kimmoli/kimdle/osaluettelo.xls

Qty | Value | Device | Package | Parts | Unit Price | Digikey part | Description | Ext Price
2 |  | SJ | SJ-SMALL | SJ1, SJ2 |  |  |  | 0
8 | 100n | C-EUC0603 | C0603 | C8, C9, C10, C11, C12, C13, C19, C22 | 0.00516 | 1276-1011-1-ND | CAP CER 0.1UF 25V Y5V 0603 | 0.04128
19 | 10k | R-EU_R0603 | R0603 | R1, R2, R4, R5, R6, R8, R9, R10, R15, R19, R20, R21, R22, R23, R24, R26, R31, R32, R33 | 0.0087 | RMCF0603FT10K0CT-ND | RES 10K OHM 1/10W 1% 0603 | 0.1653
5 | 10u 10V | C-EUC0805 | C0805 | C15, C18, C20, C21, C25 | 0.068 | 311-1355-1-ND | CAP CER 10UF 10V Y5V 0805 | 0.34
2 | 12p | C-EUC0603 | C0603 | C23, C24 | 0.016 | 1276-1254-1-ND | CAP CER 12PF 50V 5% NP0 0603 | 0.032
1 | 160k | R-EU_R0603 | R0603 | R7 | 0.067 | 541-160KHCT-ND | RES 160K OHM 1/10W 1% 0603 SMD | 0.067
1 | 165k | R-EU_R0603 | R0603 | R3 | 0.067 | 541-165KHCT-ND | RES 165K OHM 1/10W 1% 0603 SMD | 0.067
3 | 1u 50V | C-EUC0805 | C0805 | C1, C7, C14 | 0.0416 | 1276-1029-1-ND | CAP CER 1UF 50V 10% X7R 0805 | 0.1248
3 | 22R | R-EU_R0603 | R0603 | R16, R17, R34 | 0.0114 | RMCF0603FT22R0CT-ND | RES 22 OHM 1/10W 1% 0603 | 0.0342
2 | 2k15 | R-EU_R0603 | R0603 | R27, R28 | 0.0087 | RMCF0603FT2K20CT-ND | RES 2.2K OHM 1/10W 1% 0603 | 0.0174
2 | 47n | C-EUC0805 | C0805 | C16, C17 | 0.0258 | 399-1166-1-ND | CAP CER 0.047UF 50V 10% X7R 0805 | 0.0516
5 | 4u7 50V | C-EUC0805 | C0805 | C2, C3, C4, C5, C6 | 0.0816 | 1276-1248-1-ND | CAP CER 4.7UF 50V 10% X5R 0805 | 0.408
5 | 511R | R-EU_R0603 | R0603 | R11, R12, R13, R14, R25 | 0.0114 | RMCF0603FT511RCT-ND | RES 511 OHM 1/10W 1% 0603 | 0.057
1 | 629105136821 | 629105136821 | 629105136821 | X4 | 1.95 | 732-3155-1-ND | CONN RCPT USB MICRO B R/A SMT | 1.95
1 | 693071010811 | 693071010811 | 693071010811 | X5 | 1.96 | 732-3819-1-ND | CONN MICRO SD 8 POS SMD | 1.96
1 | ADP5063 | ADP5063 | QFN50P400X400X80-21N | N6 | 0 | Free sample | Linear LiFePO4 Battery Charger | 0
1 | AST7525MATRQ | AST7525MATRQ | AST7525MATRQ | E4 | 1.61 | 458-1100-1-ND | BUZZER MAG 2.7KHZ 2.5-4.5VAC SMT | 1.61
3 | FDV304 | DMG2307LSOT23 | SOT23 | V3, V4, V5 | 0.283 | FDV304PCT-ND | MOSFET P-CH 25V 460MA SOT-23 | 0.849
1 | ED060SC4_EINK | ED060SC4_EINK | FH26-39S-0.3SHW | X1 | 2.63 | HFQ339CT-ND | CONN FPC/FFC 39POS .3MM HORZ SMD | 2.63
3 | GRN | LEDCHIP-LED0603 | CHIP-LED0603 | H1, H2, H3 | 0.0563 | 475-1409-1-ND | LED CHIPLED 570NM GREEN 0603 SMD | 0.1689
2 | LPS4018B | LPS4018B | LPS4018_V2 | L1, L2 | 0.284 | 587-2886-1-ND | INDUCTOR POWER 10UH 1.2A SMD | 0.568
1 | LT3463EDD | LT3463EDD | DFN300X300X80-11N | N1 | 3.42 | LT3463AEDD#PBF-ND | IC REG INV ADJ 0.25A DL 10DFN | 3.42
1 | LM358 | MAX412CPAMSOP | SOP65P490X110-8N | N5 | 0.318 | 296-18457-1-ND | IC OPAMP GP 700KHZ DUAL 8VSSOP | 0.318
1 | MC78L15ACDG | MC78L15ACDG | SOIC127P600X175-8N | N2 | 0.33 | 497-7278-1-ND | IC REG LDO 15V 0.1A 8SO | 0.33
1 | MC79L15ACDG | MC79L15ACDG | SOIC127P600X175-8N | N3 | 0.37 | MC79L15ABDGOS-ND | IC REG LDO -15V 0.1A 8SOIC | 0.37
1 | MCP1700T-3302E/TT | MCP1700T-3302E/TT | SOT95P237X112-3N | N4 | 0.305 | MCP1700T3302ETTCT-ND | IC REG LDO 3.3V 0.25A SOT23-3 | 0.305
4 | PIIKKIRIMA-2 | PIIKKIRIMA-2 | PIIKKIRIMA-2 | X3, X7, X8, X9 |  | oma varasto |  | 0
1 | PIIKKIRIMA-4 | PIIKKIRIMA-4 | PIIKKIRIMA-4 | X10 |  | oma varasto |  | 0
1 | PIIKKIRIMA-5 | PIIKKIRIMA-5 | PIIKKIRIMA-5 | X2 |  | oma varasto |  | 0
1 | PIIKKIRIMA-6 | PIIKKIRIMA-6 | PIIKKIRIMA-6 | X6 |  | oma varasto |  | 0
1 | PMEG6010 | DIODE-SOD323-R | SOD323-R | V1 | 0.276 | 568-4138-1-ND | DIODE SCHOTTKY 60V 1A SOD323F | 0.276
1 | STM32L151R8T6 | STM32L151R8T6 | QFP50P1200X1200X160-64N | D1 | 4.73 | 497-11192-ND | MCU ARM 64KB FLASH 64LQFP | 4.73
1 | TMP75DGK | TMP75DGK | MSOP8 | D2 | 0.51 | 568-4768-1-ND | IC TEMP SENSOR DGTL 8-TSSOP | 0.51
1 | XTAL_3225_SMD | XTAL_3225_SMD | X_3225 | G1 | 0.68 | 887-1462-1-ND | CRYSTAL 16MHZ 12PF SMD | 0.68
2 | YEL | LEDCHIP-LED0603 | CHIP-LED0603 | H4, H5 | 0.563 | 475-2557-1-ND | LED CHIPLED 587NM YLW 0603 SMD | 1.126
 |  |  |  |  |  |  | Total | 23.20648
