kimmoli/kimdle/schema.pdf

## EINK DISPLAY POWER SUPPLY

# KIMDLE V1.0

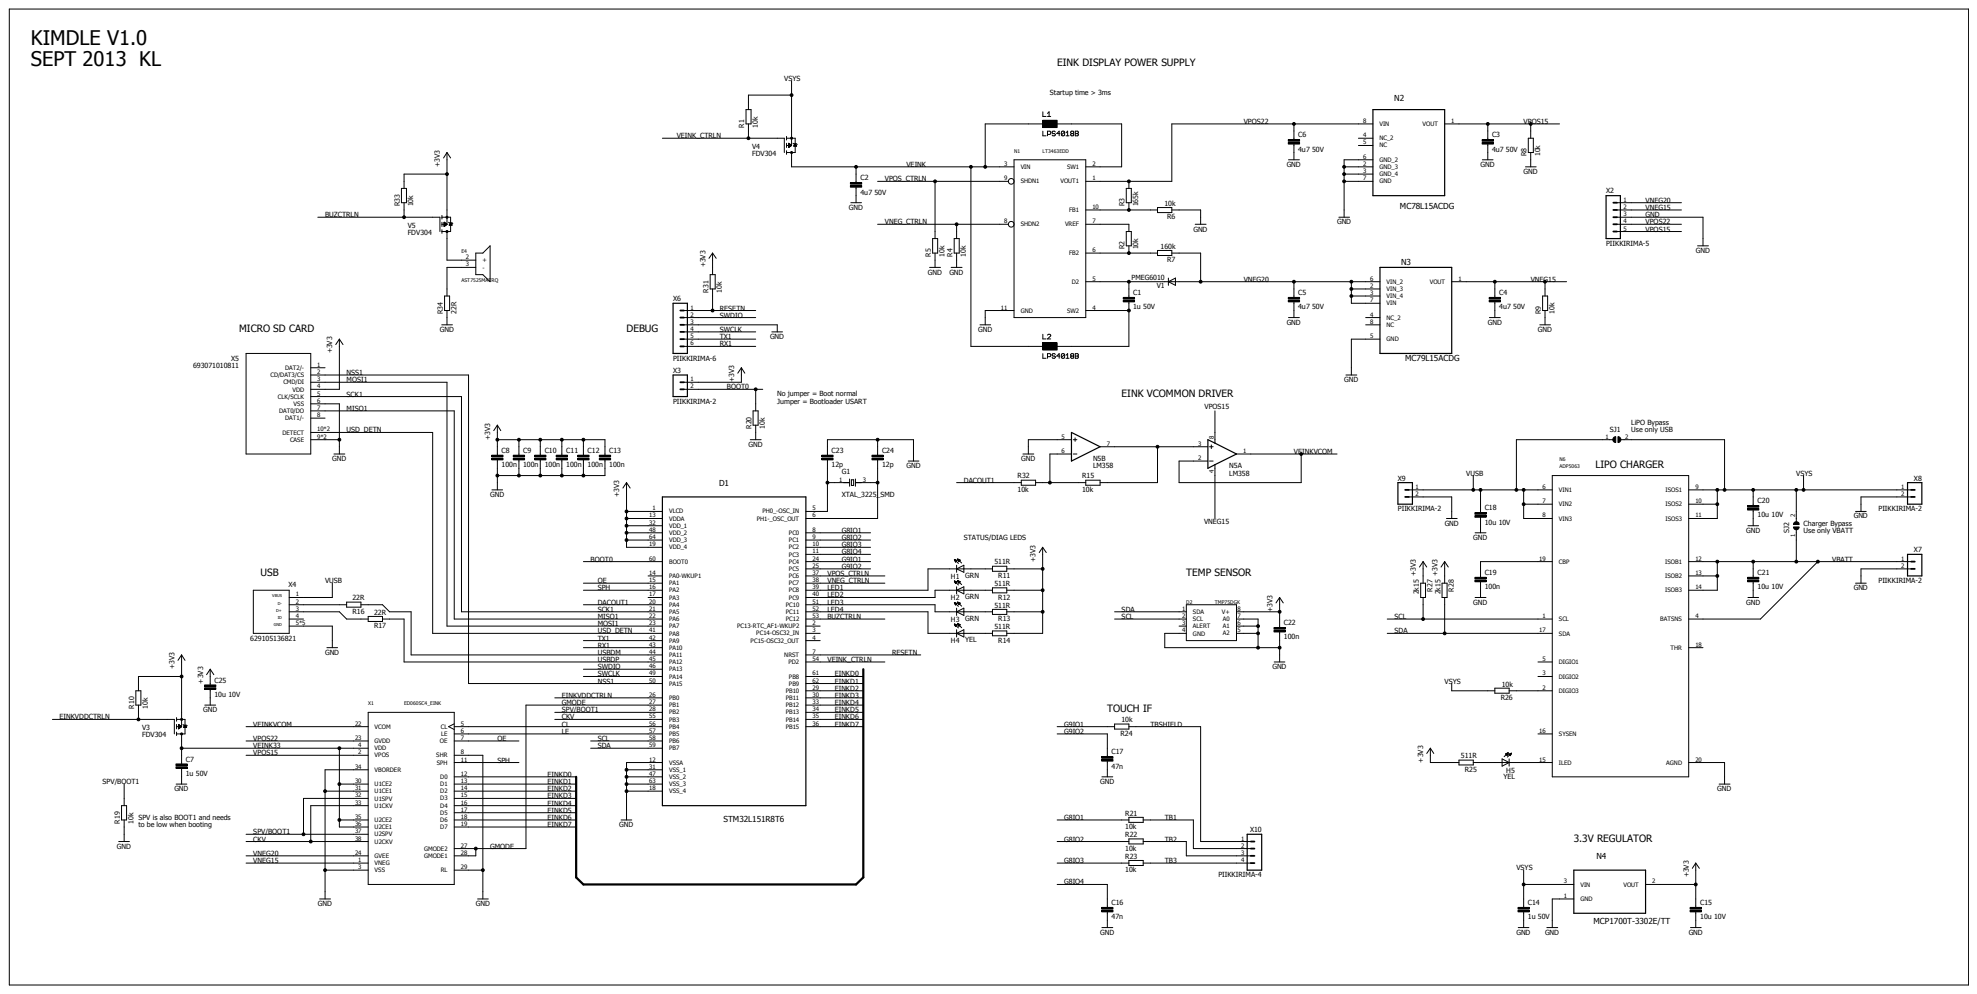
[picture p1: page 1]

No jumper = Boot normal
Jumper = Bootloader USART

SPV is also BOOT1 and needs
to be low when booting
