kimmoli/kimdle/gerber.pdf

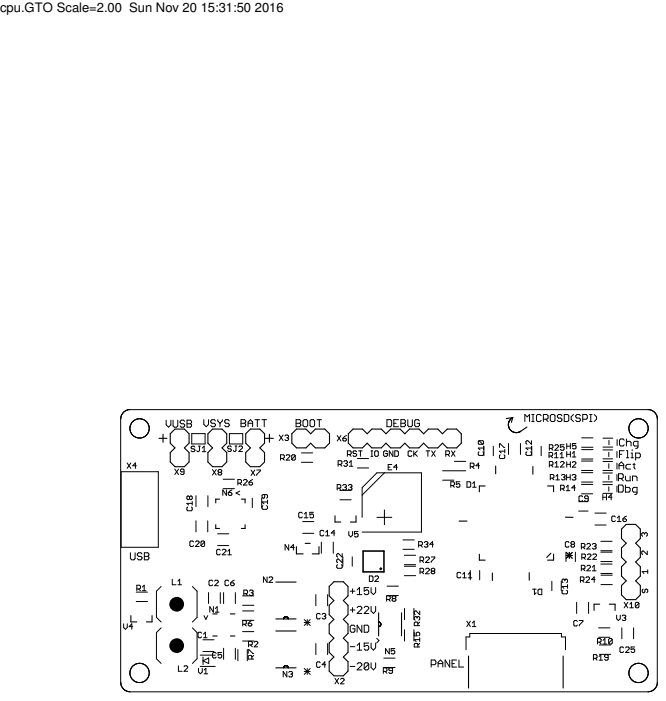
[picture p2: page 1]

cpu.GTO Scale=2.00 Sun Nov 20 15:31:50 2016

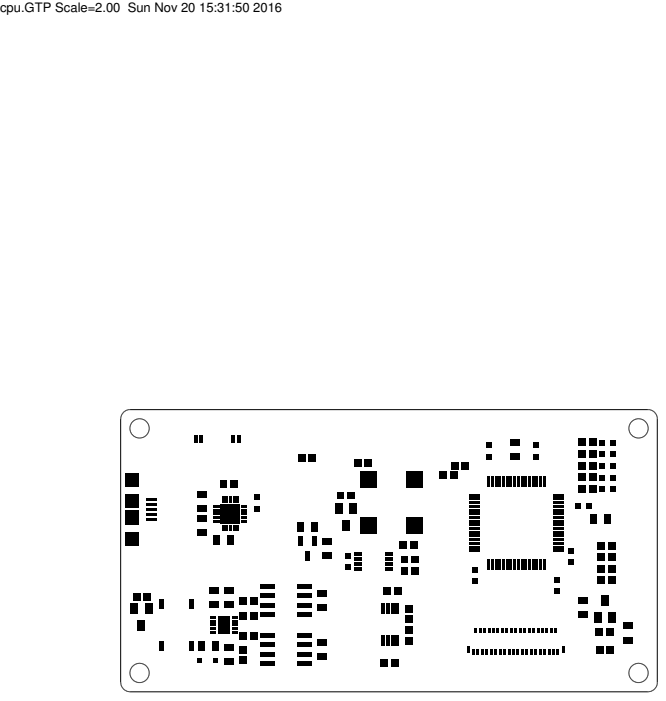
[picture p3: page 2]

cpu.GTP Scale=2.00 Sun Nov 20 15:31:50 2016

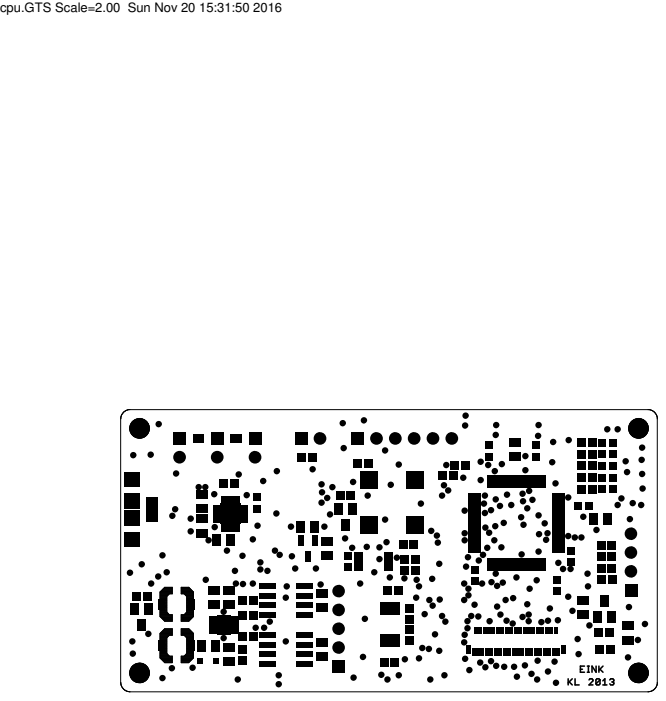
[picture p4: page 3]

cpu.GTS Scale=2.00 Sun Nov 20 15:31:50 2016

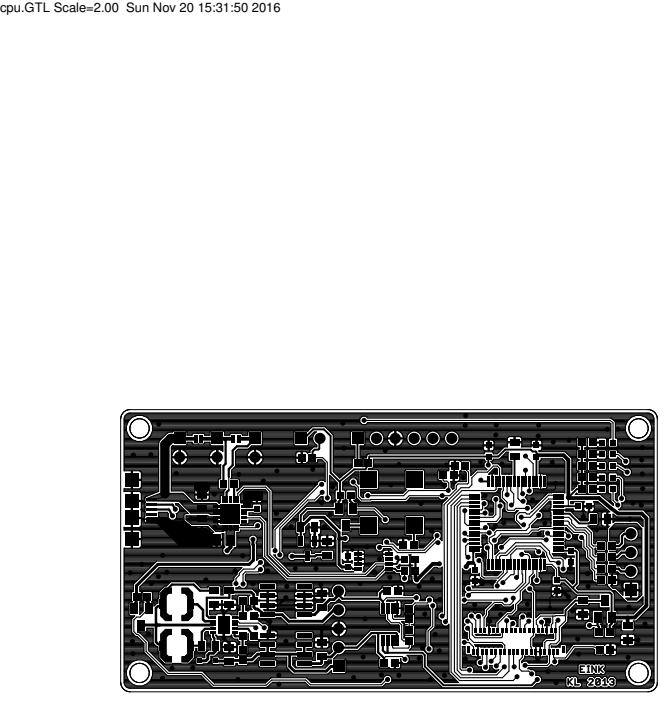
[picture p5: page 4]

cpu.GTL Scale=2.00 Sun Nov 20 15:31:50 2016

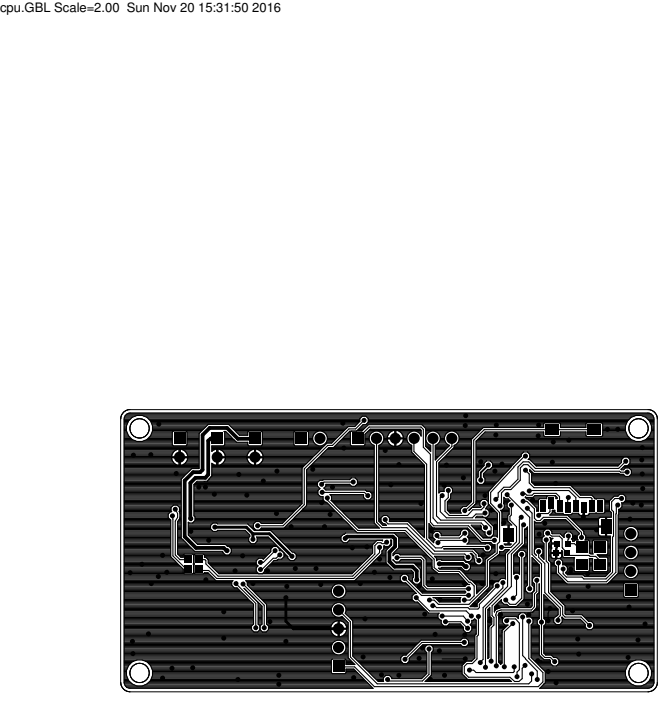
[picture p6: page 5]

cpu.GBL Scale=2.00 Sun Nov 20 15:31:50 2016

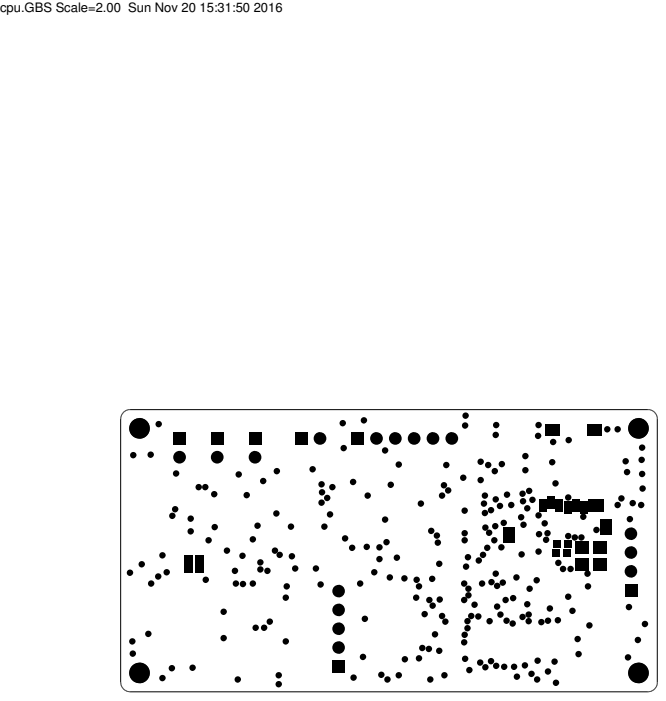
[picture p7: page 6]

cpu.GBS Scale=2.00 Sun Nov 20 15:31:50 2016

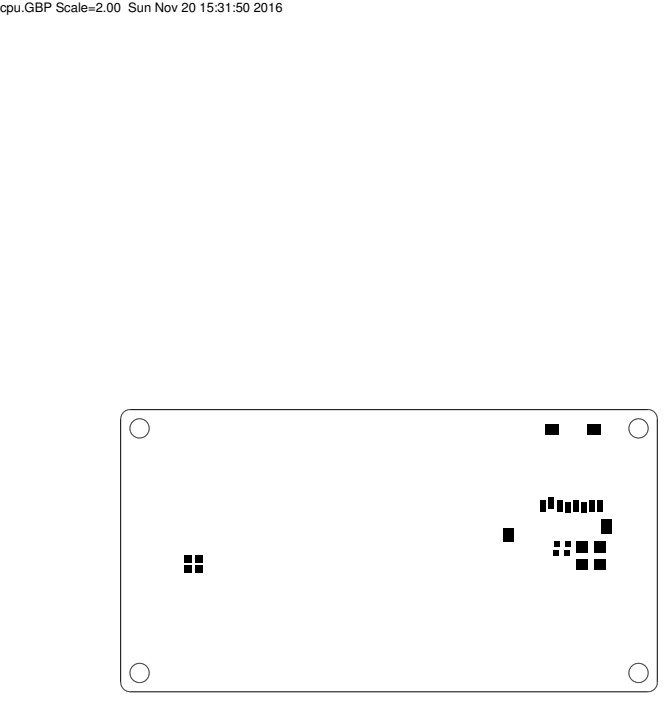
[picture p8: page 7]

cpu.GBP Scale=2.00 Sun Nov 20 15:31:50 2016

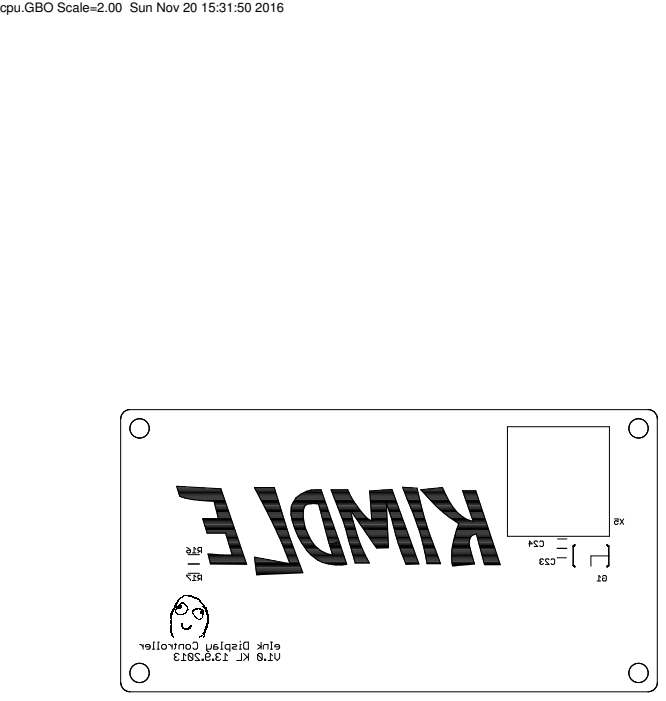
[picture p9: page 8]

cpu.GBO Scale=2.00 Sun Nov 20 15:31:50 2016

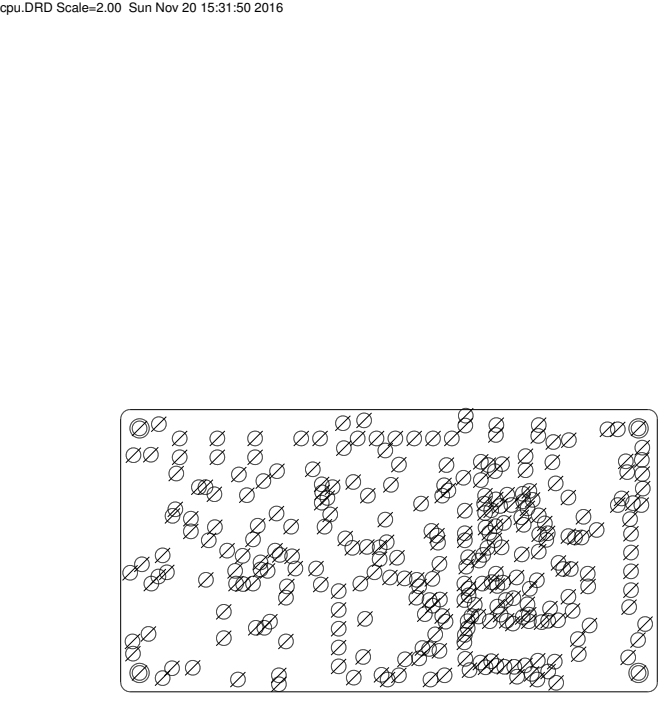
[picture p10: page 9]

cpu.DRD Scale=2.00 Sun Nov 20 15:31:50 2016

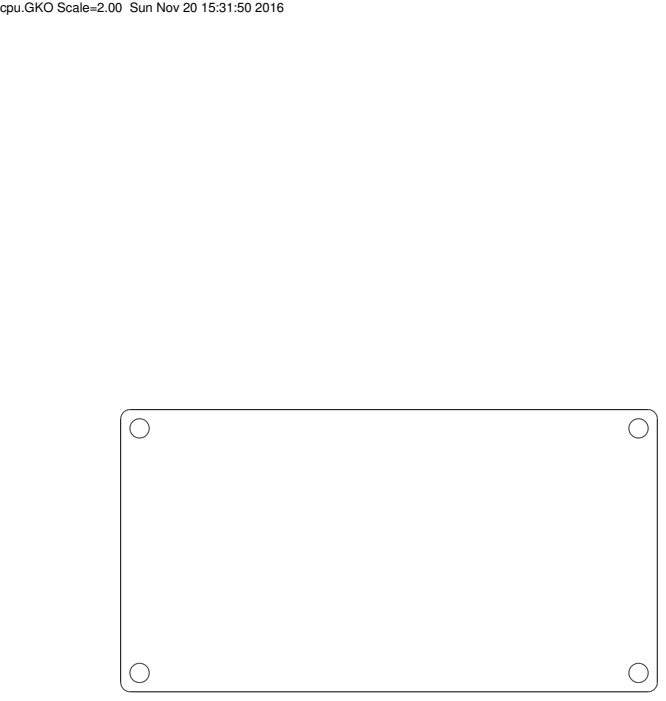
[picture p11: page 10]

cpu.GKO Scale=2.00 Sun Nov 20 15:31:50 2016

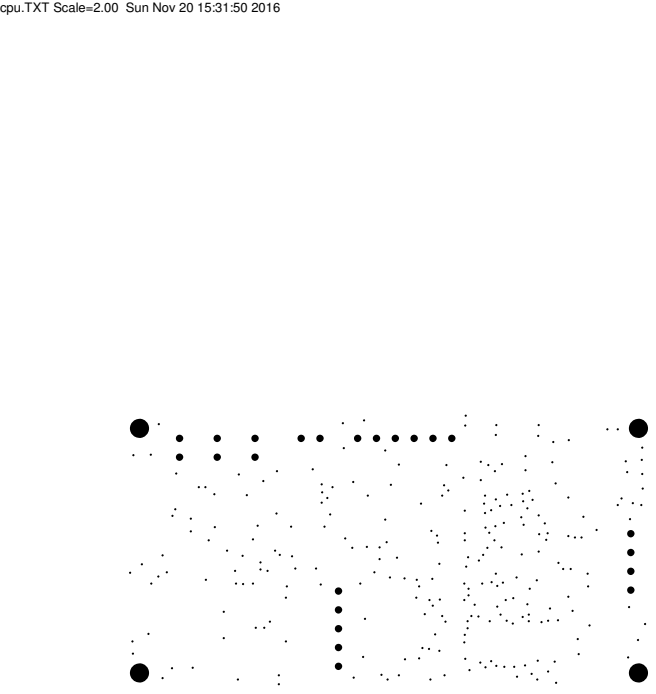
[picture p12: page 11]

cpu.TXT Scale=2.00 Sun Nov 20 15:31:50 2016
