kimmoli/kimdle/cpu.brd

## EAGLE design cpu.brd (2013-09-13)

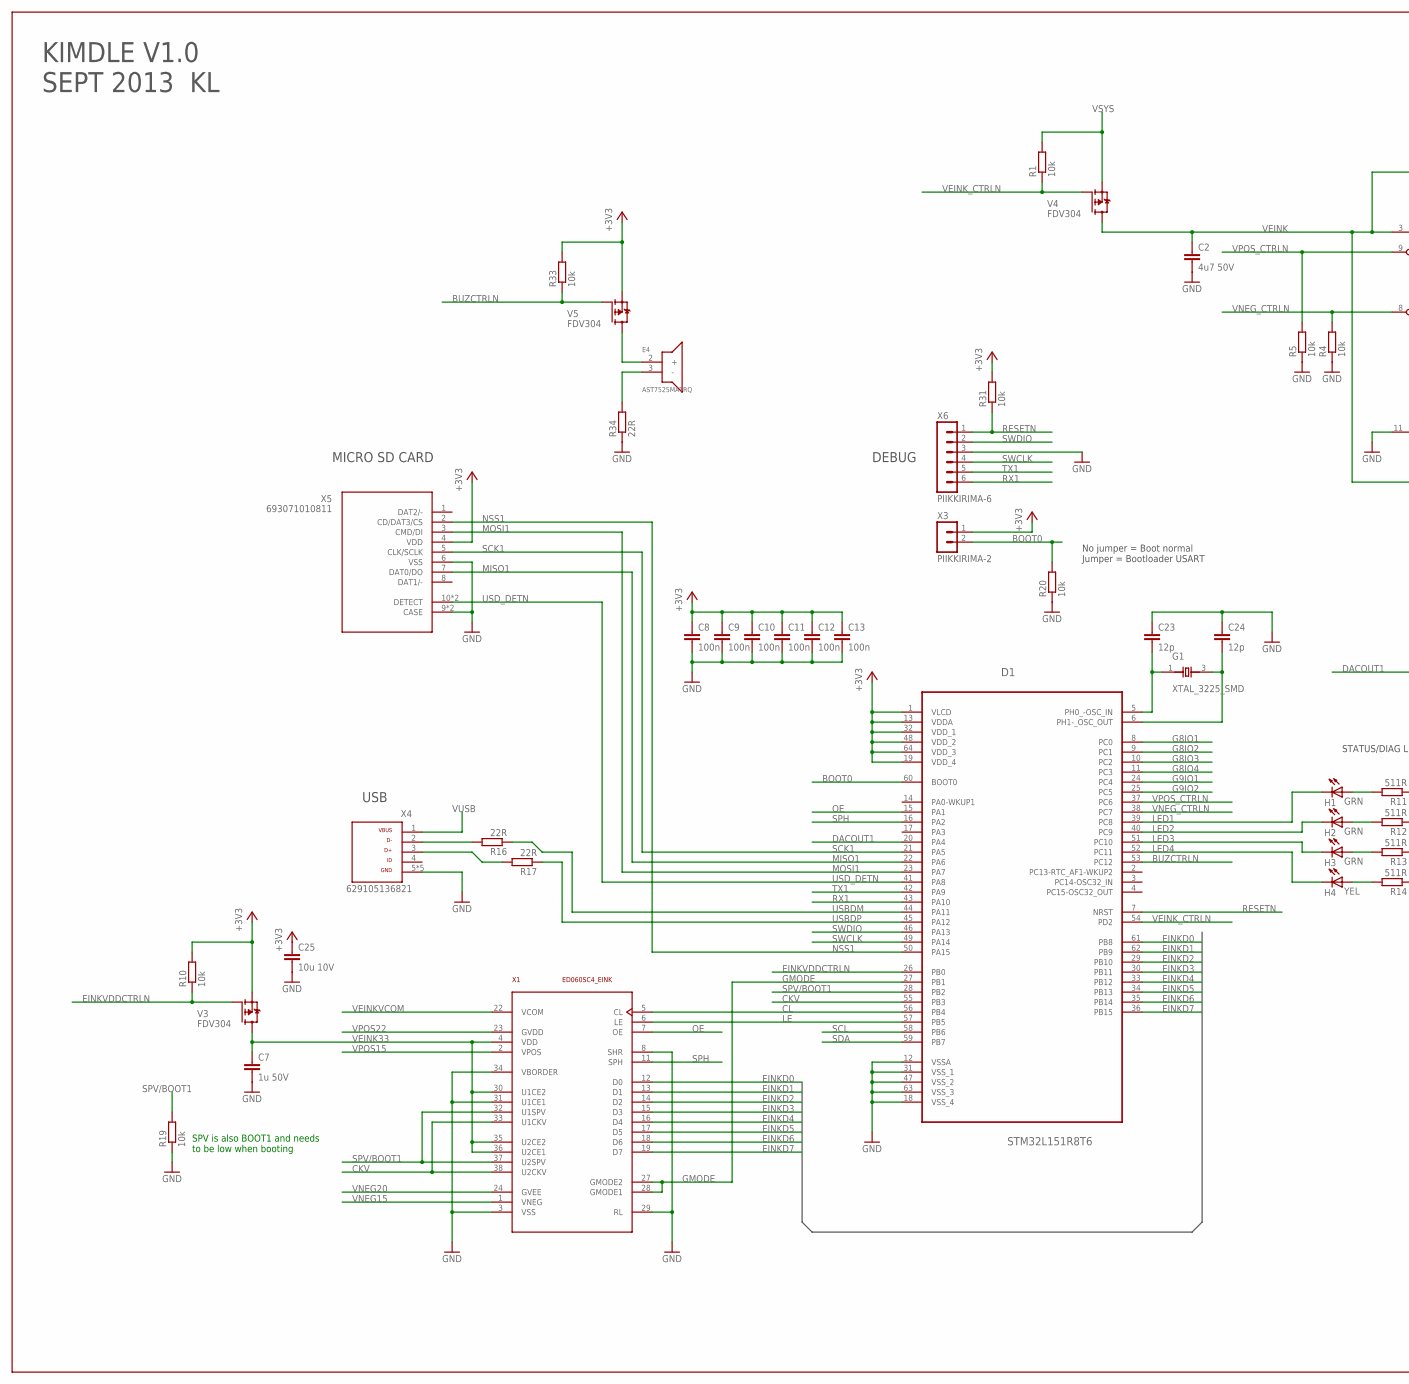
[picture p13: schematic cpu.sch, part in row 1, column 1]

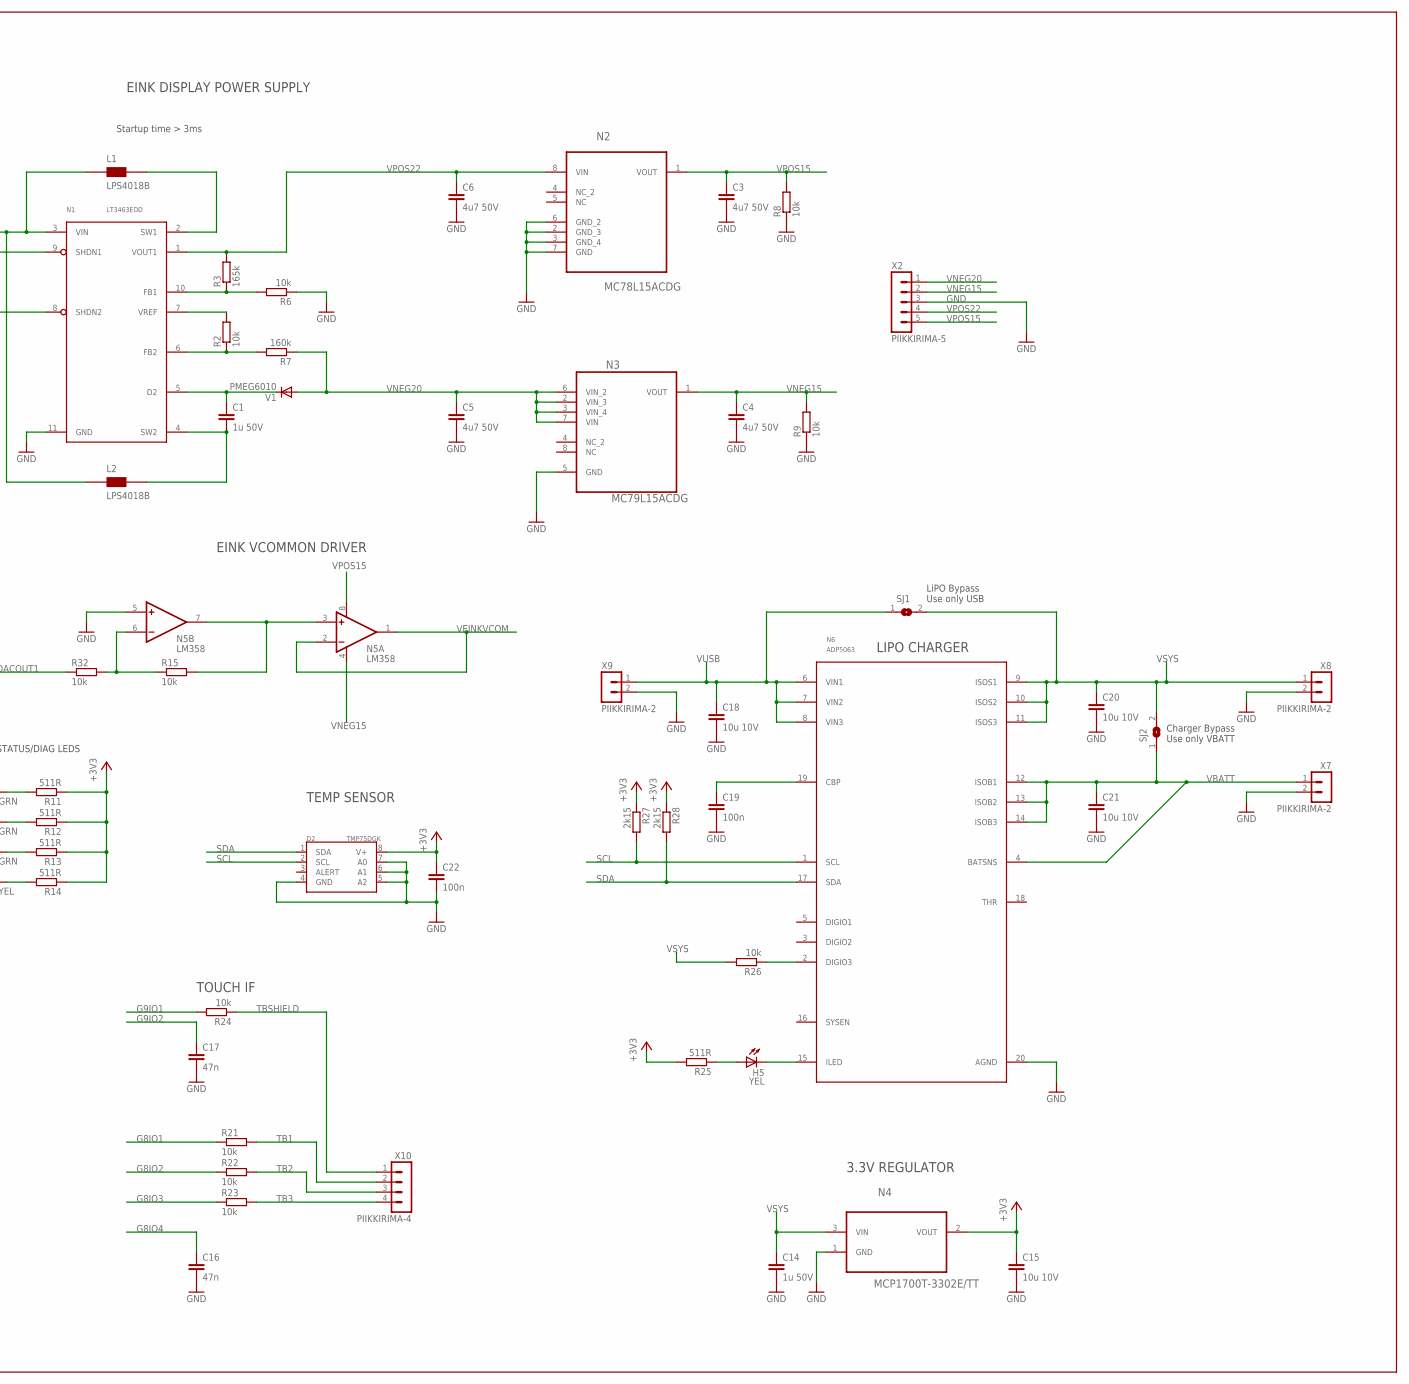
[picture p14: schematic cpu.sch, part in row 1, column 2]

Parts:
C1, C7, C14: 1u 50V; C0805
C2, C3, C4, C5, C6: 4u7 50V; C0805
C8, C9, C10, C11, C12, C13, C19, C22: 100n; C0603
C15, C18, C20, C21, C25: 10u 10V; C0805
C16, C17: 47n; C0805
C23, C24: 12p; C0603
D1: STM32L151R8T6; QFP50P1200X1200X160-64N
D2: TMP75DGK; MSOP8
E4: AST7525MATRQ
G1: XTAL_3225_SMD; X_3225
H1, H2, H3: GRN; CHIP-LED0603
H4, H5: YEL; CHIP-LED0603
L1, L2: LPS4018B; LPS4018_V2
N1: LT3463EDD; DFN300X300X80-11N
N2: MC78L15ACDG; SOIC127P600X175-8N
N3: MC79L15ACDG; SOIC127P600X175-8N
N4: MCP1700T-3302E/TT; SOT95P237X112-3N
N5: LM358; SOP65P490X110-8N
N6: ADP5063; QFN50P400X400X80-21N
R1, R2, R4, R5, R6, R8, R9, R10, R15, R19, R20, R21, R22, R23, R24, R26, R31, R32, R33: 10k; R0603
R3: 165k; R0603
R7: 160k; R0603
R11, R12, R13, R14, R25: 511R; R0603
R16, R17, R34: 22R; R0603
R27, R28: 2k15; R0603
SJ1, SJ2: SJ; SJ-SMALL
V1: PMEG6010; SOD323-R
V3, V4, V5: FDV304; SOT23
X1: ED060SC4_EINK; FH26-39S-0.3SHW
X2: PIIKKIRIMA-5
X3, X7, X8, X9: PIIKKIRIMA-2
X4: 629105136821
X5: 693071010811
X6: PIIKKIRIMA-6
X10: PIIKKIRIMA-4

Connections:
+3V3: C8.1, C9.1, C10.1, C11.1, C12.1, C13.1, C15.1, C22.1, C25.1, D1.1 (VLCD), D1.13 (VDDA), D1.19 (VDD_4), D1.32 (VDD_1), D1.48 (VDD_2), D1.64 (VDD_3), D2.8 (V+), N4.2 (VOUT), R10.2, R11.1, R12.1, R13.1, R14.1, R25.2, R27.1, R28.1, R31.2, R33.2, V3.2 (S), V5.2 (S), X3.1, X5.4 (VDD)
BOOT0: D1.60 (BOOT0), R20.2, X3.2
BUZCTRLN: D1.53 (PC12), R33.1, V5.1 (G)
CKV: D1.55 (PB3), X1.33 (U1CKV), X1.38 (U2CKV)
CL: D1.56 (PB4), X1.5 (CL)
DACOUT1: D1.20 (PA4), R32.1
EINKD0: D1.61 (PB8), X1.12 (D0)
EINKD1: D1.62 (PB9), X1.13 (D1)
EINKD2: D1.29 (PB10), X1.14 (D2)
EINKD3: D1.30 (PB11), X1.15 (D3)
EINKD4: D1.33 (PB12), X1.16 (D4)
EINKD5: D1.34 (PB13), X1.17 (D5)
EINKD6: D1.35 (PB14), X1.18 (D6)
EINKD7: D1.36 (PB15), X1.19 (D7)
EINKVDDCTRLN: D1.26 (PB0), R10.1, V3.1 (G)
G8IO1: D1.8 (PC0), R21.1
G8IO2: D1.9 (PC1), R22.1
G8IO3: D1.10 (PC2), R23.1
G8IO4: C16.1, D1.11 (PC3)
G9IO1: D1.24 (PC4), R24.2
G9IO2: C17.1, D1.25 (PC5)
GMODE: D1.27 (PB1), X1.27 (GMODE2), X1.28 (GMODE1)
GND: C2.2, C3.2, C4.2, C5.2, C6.2, C7.2, C8.2, C9.2, C10.2, C11.2, C12.2, C13.2, C14.2, C15.2, C16.2, C17.2, C18.2, C19.2, C20.2, C21.2, C22.2, C23.1, C24.1, C25.2, D1.12 (VSSA), D1.18 (VSS_4), D1.31 (VSS_1), D1.47 (VSS_2), D1.63 (VSS_3), D2.4 (GND), D2.5 (A2), D2.6 (A1), D2.7 (A0), N1.11 (GND), N2.2 (GND_3), N2.3 (GND_4), N2.6 (GND_2), N2.7 (GND), N3.5 (GND), N4.1 (GND), N5.5 (+IN), N6.20 (AGND), R4.1, R5.1, R6.1, R8.1, R9.1, R19.1, R20.1, R34.1, X1.3 (VSS), X1.8 (SHR), X1.29 (RL), X1.31 (U1CE1), X1.34 (VBORDER), X2.3, X4.5, X4.Z1 (5), X4.Z2 (5), X4.Z3 (5), X4.Z4 (5), X5.6 (VSS), X5.9 (CASE), X5.9B (CASE), X6.3, X7.2, X8.2, X9.2
LE: D1.57 (PB5), X1.6 (LE)
LED1: D1.39 (PC8), H1.C
LED2: D1.40 (PC9), H2.C
LED3: D1.51 (PC10), H3.C
LED4: D1.52 (PC11), H4.C
MISO1: D1.22 (PA6), X5.7 (DAT0/DO)
MOSI1: D1.23 (PA7), X5.3 (CMD/DI)
unnamed: C1.1, N1.5 (D2), V1.C
unnamed: R17.2, X4.3
unnamed: N1.6 (FB2), R2.1, R7.2
unnamed: R16.2, X4.2
unnamed: E4.3 (-), R34.2
unnamed: L1.2 (B), N1.2 (SW1)
unnamed: C1.2, L2.2 (B), N1.4 (SW2)
unnamed: N5.3 (+IN), N5.7 (OUT), R15.2
unnamed: N1.7 (VREF), R2.2
unnamed: H1.A, R11.2
unnamed: N1.10 (FB1), R3.1, R6.2
unnamed: C23.2, D1.5 (PH0_-OSC_IN), G1.1 (X1)
unnamed: H2.A, R12.2
unnamed: C24.2, D1.6 (PH1-_OSC_OUT), G1.3 (X2)
unnamed: H3.A, R13.2
unnamed: H4.A, R14.2
unnamed: N5.6 (-IN), R15.1, R32.2
unnamed: H5.C, N6.15 (ILED)
unnamed: C19.1, N6.19 (CBP)
unnamed: H5.A, R25.1
unnamed: N6.2 (DIGIO3), R26.1
NSS1: D1.50 (PA15), X5.2 (CD/DAT3/CS)
OE: D1.15 (PA1), X1.7 (OE)
RESETN: D1.7 (NRST), R31.1, X6.1
RX1: D1.43 (PA10), X6.6
SCK1: D1.21 (PA5), X5.5 (CLK/SCLK)
SCL: D1.58 (PB6), D2.2 (SCL), N6.1 (SCL), R27.2
SDA: D1.59 (PB7), D2.1 (SDA), N6.17 (SDA), R28.2
SPH: D1.16 (PA2), X1.11 (SPH)
SPV/BOOT1: D1.28 (PB2), R19.2, X1.32 (U1SPV), X1.37 (U2SPV)
SWCLK: D1.49 (PA14), X6.4
SWDIO: D1.46 (PA13), X6.2
TB1: R21.2, X10.2
TB2: R22.2, X10.3
TB3: R23.2, X10.4
TBSHIELD: R24.1, X10.1
TX1: D1.42 (PA9), X6.5
USBDM: D1.44 (PA11), R16.1
USBDP: D1.45 (PA12), R17.1
USD_DETN: D1.41 (PA8), X5.10 (DETECT), X5.10B (DETECT)
VBATT: C21.1, N6.4 (BATSNS), N6.12 (ISOB1), N6.13 (ISOB2), N6.14 (ISOB3), SJ2.1, X7.1
VEINK: C2.1, L1.1 (A), L2.1 (A), N1.3 (VIN), V4.3 (D)
VEINK1: E4.2 (+), V5.3 (D)
VEINK33: C7.1, V3.3 (D), X1.4 (VDD), X1.30 (U1CE2), X1.35 (U2CE2), X1.36 (U2CE1)
VEINKVCOM: N5.1 (OUT), N5.2 (-IN), X1.22 (VCOM)
VEINK_CTRLN: D1.54 (PD2), R1.1, V4.1 (G)
VNEG15: C4.1, N3.1 (VOUT), N5.4 (V-), R9.2, X1.1 (VNEG), X2.2
VNEG20: C5.1, N3.2 (VIN_3), N3.3 (VIN_4), N3.6 (VIN_2), N3.7 (VIN), R7.1, V1.A, X1.24 (GVEE), X2.1
VNEG_CTRLN: D1.38 (PC7), N1.8 (SHDN2), R4.2
VPOS15: C3.1, N2.1 (VOUT), N5.8 (V+), R8.2, X1.2 (VPOS), X2.5
VPOS22: C6.1, N1.1 (VOUT1), N2.8 (VIN), R3.2, X1.23 (GVDD), X2.4
VPOS_CTRLN: D1.37 (PC6), N1.9 (SHDN1), R5.2
VSYS: C14.1, C20.1, N4.3 (VIN), N6.9 (ISOS1), N6.10 (ISOS2), N6.11 (ISOS3), R1.2, R26.2, SJ1.2, SJ2.2, V4.2 (S), X8.1
VUSB: C18.1, N6.6 (VIN1), N6.7 (VIN2), N6.8 (VIN3), SJ1.1, X4.1, X9.1

Notes on the sheet:
STATUS/DIAG LEDS
DEBUG
USB
MICRO SD CARD
SPV is also BOOT1 and needs to be low when booting
No jumper = Boot normal Jumper = Bootloader USART
TOUCH IF
LIPO CHARGER
3.3V REGULATOR
EINK DISPLAY POWER SUPPLY
LiPO Bypass Use only USB
Charger Bypass Use only VBATT
KIMDLE V1.0 SEPT 2013 KL
EINK VCOMMON DRIVER
Startup time > 3ms
TEMP SENSOR

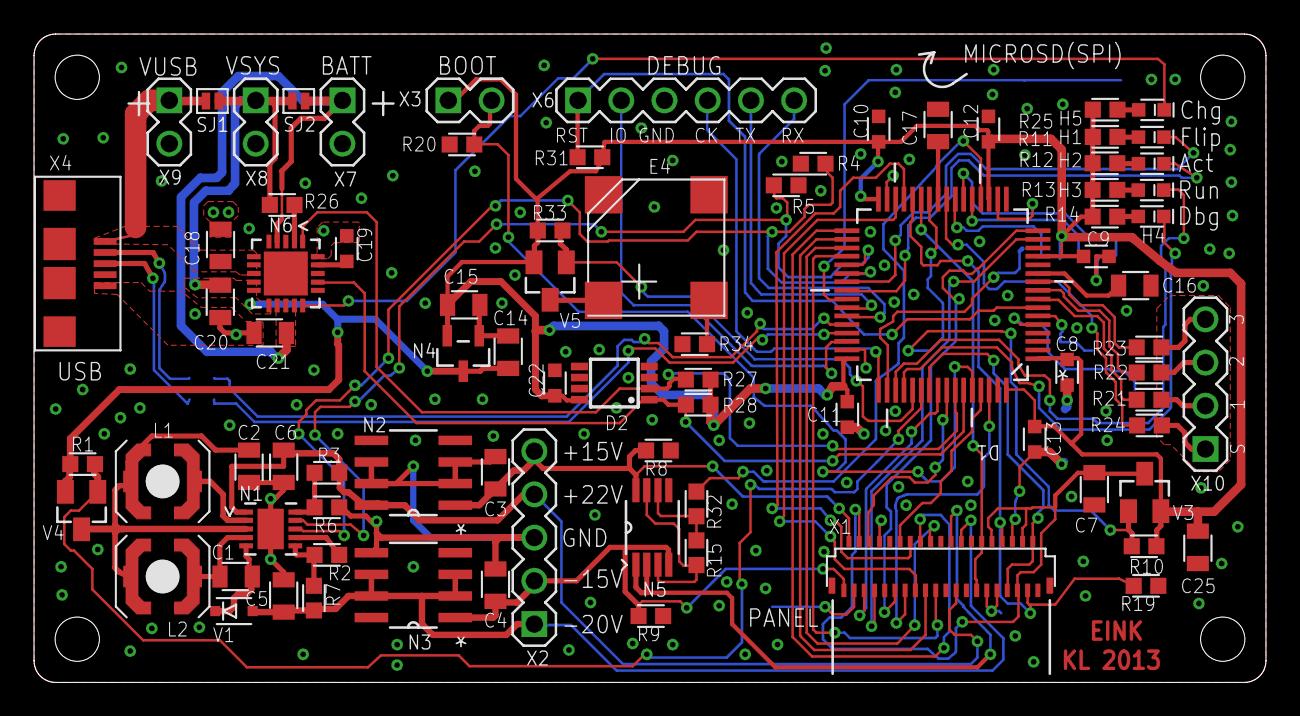
[picture p15: board cpu.brd from above]

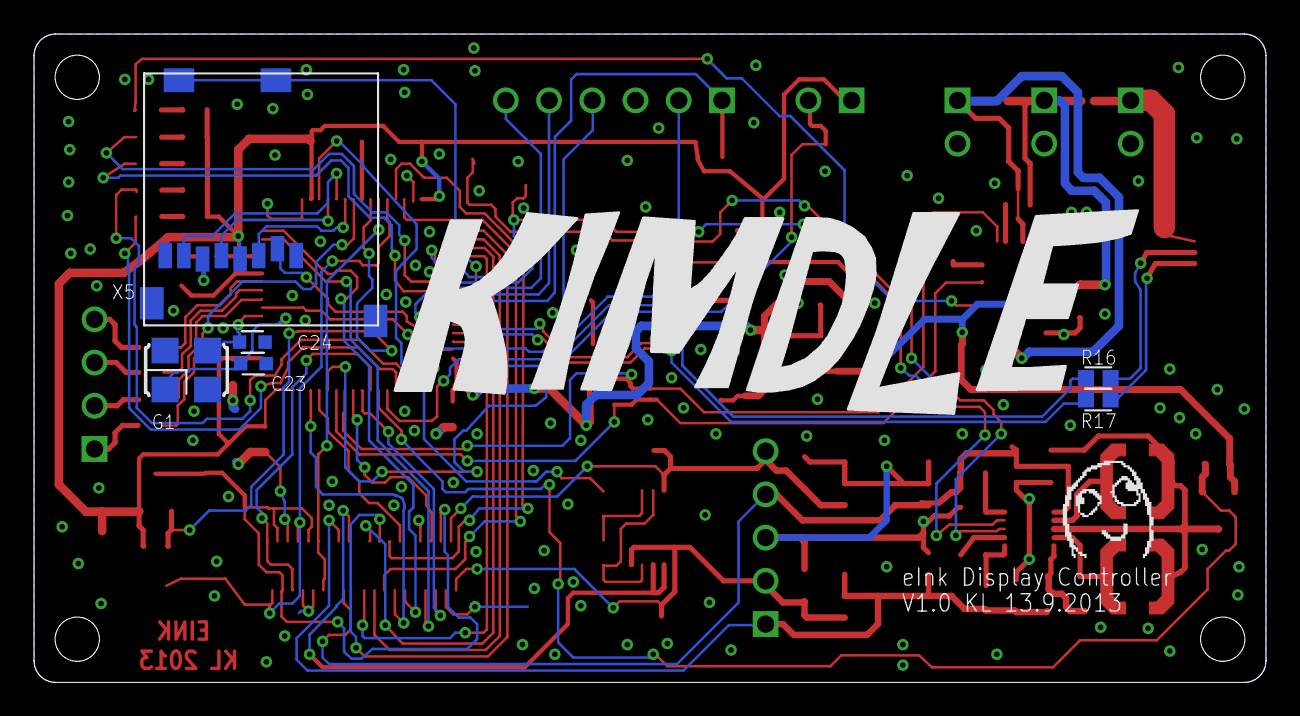
[picture p16: board cpu.brd from below]

Board: 2 copper layers, 72.4 x 38.1 mm, 90 parts (7 on the bottom side), 84 nets.

Other parts of the board:
U$3: DAFUG
