kimmoli/kimdle/(commit log)

2013-09-10 First commit
    EINK Powersupply
    [cpu.brd, cpu.sch]
2013-09-11 Schematic should be complete
    Schematic should have all parts now
    [cpu.brd, cpu.sch]
2013-09-11 Buzzer added
    Added smalles affordable buzzer.
    [cpu.brd, cpu.sch]
2013-09-11 Layout commit 1
    First commit with some layout/placement
    [cpu.brd, cpu.sch]
2013-09-11 All parts first time onboard - placed
    Touchbuttons also prelocated for OSHpark testing
    [cpu.brd, cpu.sch]
2013-09-11 Layout cont
    Flex connector first routing attempt. not nice. too many vias...
    [cpu.brd]
2013-09-12 Layout cont2
    17 airwires left.
    touch buttons removed from cpu board
    [cpu.brd, cpu.sch]
2013-09-12 Layout complete
    First completed layout , Airwires 0
    [cpu.brd, cpu.sch]
2013-09-12 Finetuning
    USB connector moved closer to edge etc.
    [cpu.brd, cpu.sch]
2013-09-12 HSE Crystal added
    Added G1, 3.2x2.5 mm crystal. bottom.
    [cpu.brd, cpu.sch]
2013-09-12 Bypass, tuning
    One 0805 bulk bypass added.
    GND fills fixed close G1
    [cpu.brd, cpu.sch]
2013-09-12 Power control signals added
    DCDC Converter enables (all three) were missing from schematic.
    Processor grounds connected too.
    [cpu.brd, cpu.sch]
2013-09-13 Final - ready to order
    Part values added
    [cpu.brd, cpu.sch, osaluettelo.xls]
2013-09-13 KIMDLE logo
    Logo added - saying KIMDLE on bottom
    [cpu.brd]
2013-09-13 KIMDLE logo revisited
    The imported bitmap was rejected by OSHpark. made my own from polygons
    [cpu.brd]
2016-11-20 schema and gerber pdf
